Fab-Lab-Akureyri/fla-modular-things-stepper/README.md

# fla-modular-things-stepper

## Íslenska
KiCad útgáfa af [RP2040 stepper mótor](https://github.com/modular-things/modular-things/tree/main/arduino/stepper-hbridge-rp2040) [Modular things](https://github.com/modular-things/). 

Byggt á útgáfu [Yuichi Tamiya](https://gitlab.fabcloud.org/yuichitamiya) frá því [Instructors Bootcamp](http://academany.fabcloud.io/fabacademy/2023/instructors-bootcamp/Projects/xiao_rp2040_hbridges/) í [Amsterdam 2023](http://academany.fabcloud.io/fabacademy/2023/instructors-bootcamp/) en með uppfærðum [pinnum](https://github.com/modular-things/modular-things/commit/0fbb3a3acf8de46f2caffaf1a5243ba7b4b4830b). 

## English 

KiCad project [RP2040 stepper motor](https://github.com/modular-things/modular-things/tree/main/arduino/stepper-hbridge-rp2040) [Modular things](https://github.com/modular-things/). 

Based on [Yuichi Tamiya's](https://gitlab.fabcloud.org/yuichitamiya) version from the [Instructors Bootcamp](http://academany.fabcloud.io/fabacademy/2023/instructors-bootcamp/Projects/xiao_rp2040_hbridges/) in [Amsterdam 2023](http://academany.fabcloud.io/fabacademy/2023/instructors-bootcamp/) with updated [pinout](https://github.com/modular-things/modular-things/commit/0fbb3a3acf8de46f2caffaf1a5243ba7b4b4830b). 

## BOM

| NR | Designator | Footprint | Quantity  | Designation |
| --- | --- | --- | --- | --- |
| 1 | R6,R7	 | R_1206	 | 2 | 0 ohm |
| 2 | M1 | SeeedStudio_XIAO_SocketSMD	 | 1 | XIAO-RP2040_SocketSMD |
| 3 | R2,R4	 | R_2010	 | 2 | 0.250 ohm |
| 4 | R3,R1	 | R_1206	 | 2 | 100 ohm |
| 5 | C1,C4	 | C_1206	 | 2 | 0.1 uF |
| 6 | C5,C2	 | C_1206	 | 2 | 1uF |
| 7 | C6,C3	 | C_1206	 | 2 | 10uF |
| 8 | UB1,UA1	 | HSOP-8	 | 2 | TB67H451FNG |
| 9 | J1	 | PinHeader_1x04_P2.54mm_Horizontal_SMD | 1 | Conn_PinHeader_1x04_P2.54mm_Horizontal_SMD |

## Images

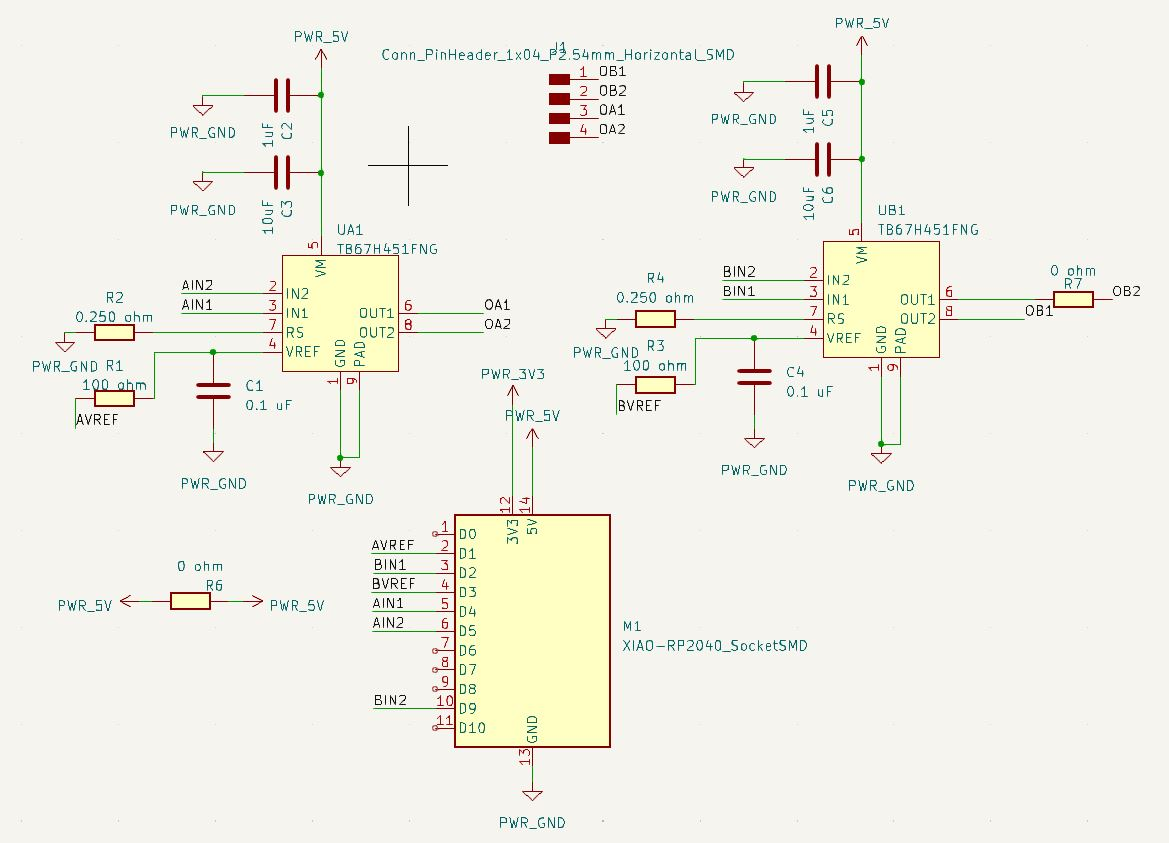
[picture p1: schematic.jpg]
Schematic

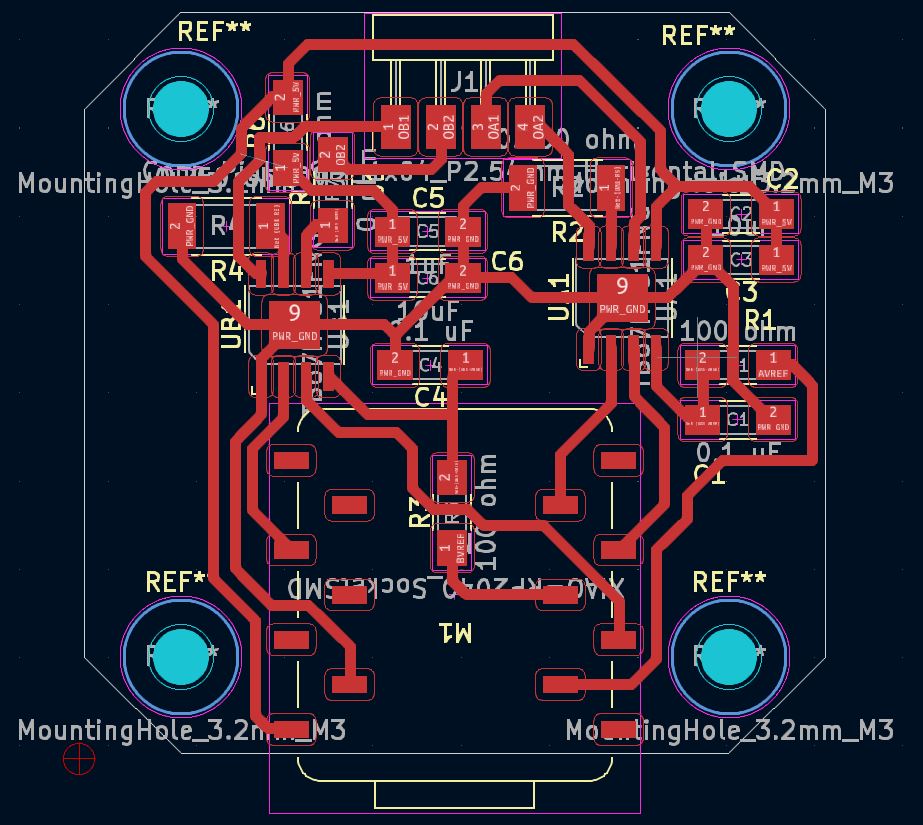
[picture p2: pcb.jpg]
PCB


Note: I only had the male headers for the board, I would have preferred to have the female headers on the board. 

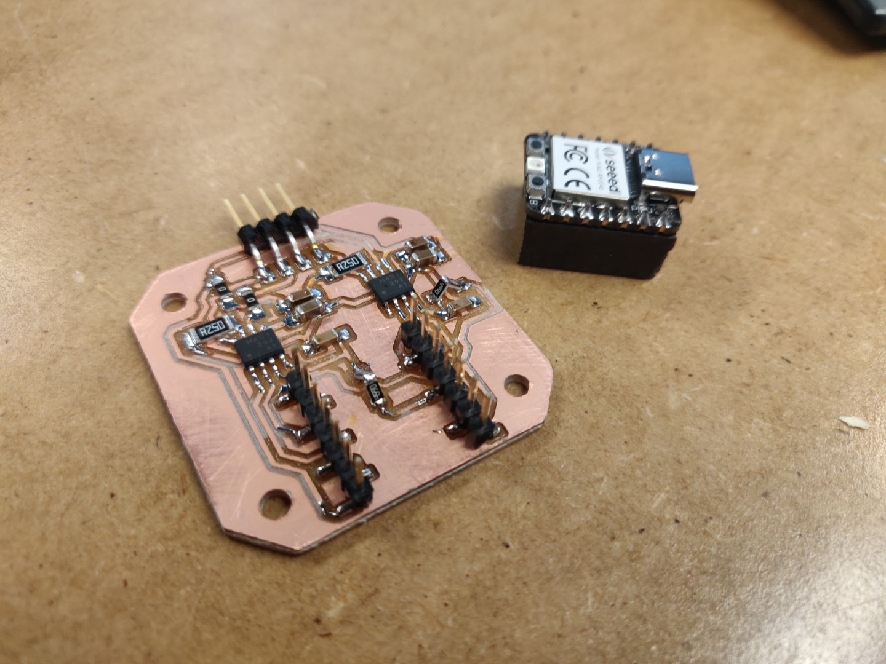
[picture p3: board.jpg]
Board
