Fab-Lab-Akureyri/fla-modular-things-stepper/xiao-stepper.kicad_pcb

## KiCad design xiao-stepper.kicad_pcb (2023-05-08)

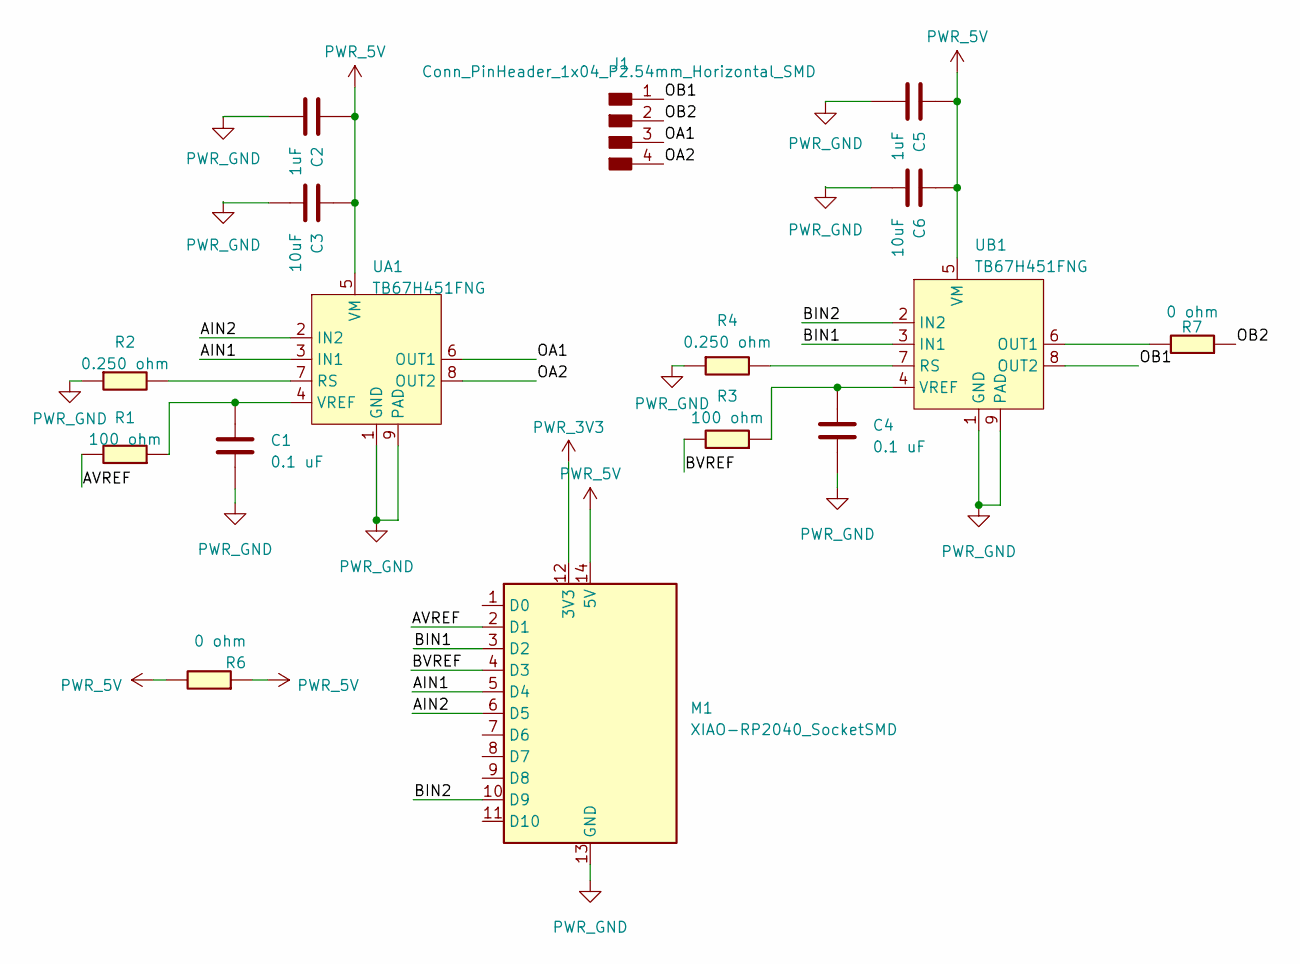
[picture p4: schematic xiao-stepper.kicad_sch]

Parts:
C1, C4: 0.1 uF; C_1206
C2, C5: 1uF; C_1206
C3, C6: 10uF; C_1206
J1: Conn_PinHeader_1x04_P2.54mm_Horizontal_SMD; PinHeader_1x04_P2.54mm_Horizontal_SMD
M1: XIAO-RP2040_SocketSMD; SeeedStudio_XIAO_SocketSMD
R1, R3: 100 ohm; R_1206
R2, R4: 0.250 ohm; R_2010
R6, R7: 0 ohm; R_1206
UA1: TB67H451FNG; HSOP-8
UB1: TB67H451FNG; HSOP-8

Connections:
/AIN1: M1.5 (D4), UA1.3 (IN1)
/AIN2: M1.6 (D5), UA1.2 (IN2)
/AVREF: M1.2 (D1), R1.1
/BIN1: M1.3 (D2), UB1.3 (IN1)
/BIN2: M1.10 (D9), UB1.2 (IN2)
/BVREF: M1.4 (D3), R3.1
/OA1: J1.3, UA1.6 (OUT1)
/OA2: J1.4, UA1.8 (OUT2)
/OB1: J1.1, UB1.8 (OUT2)
/OB2: J1.2, R7.2
unnamed: R2.1, UA1.7 (RS)
unnamed: C1.1, R1.2, UA1.4 (VREF)
unnamed: R7.1, UB1.6 (OUT1)
unnamed: R4.1, UB1.7 (RS)
unnamed: C4.1, R3.2, UB1.4 (VREF)
PWR_3V3: M1.12 (3V3)
PWR_5V: C2.1, C3.1, C5.1, C6.1, M1.14 (5V), R6.1, R6.2, UA1.5 (VM), UB1.5 (VM)
PWR_GND: C1.2, C2.2, C3.2, C4.2, C5.2, C6.2, M1.13 (GND), R2.2, R4.2, UA1.1 (GND), UA1.9 (PAD), UB1.1 (GND), UB1.9 (PAD)

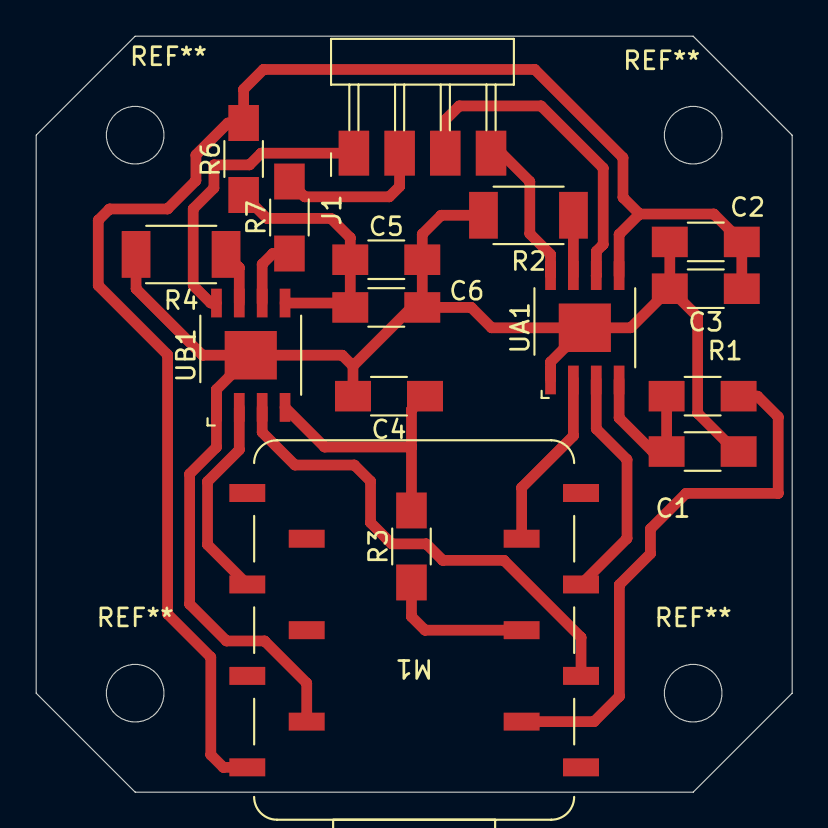
[picture p5: board xiao-stepper.kicad_pcb from above]

Board: 2 copper layers, 42.0 x 42.0 mm, 16 parts (0 on the bottom side), 17 nets.
