Fab-Lab-Akureyri/fla-modular-things-stepper/(commit log)

2023-05-08 Updated readme and changed 120ohm to 100ohm
    [xiao-stepper.kicad_pcb, xiao-stepper.kicad_sch]
2023-05-08 Added images
    [xiao-stepper.kicad_sch]
2023-05-08 Updated pcb image
2023-05-08 Updated PCB schematic
    [xiao-stepper.kicad_pcb]
